RideTheVibe/engineering-docs/README.md

# engineering-docs

Engineering Docs for Vibe - The One Wheel Self-Balancing E-Bike
