RideTheVibe/engineering-docs/content/docs/AllDownloadables.mdx

---
title: All Downloadables
description: All downloadable files in one easy place.
---

import {DownloadCard} from "../../src/Components/DownloadCard/DownloadFile";

## Electrical

<DownloadCard fileName={"DMU11-BreakoutBoard-gerber.zip"} fileLocation={"/files/dmu11-mating-connector.zip"} />

## Fabrication

### Metal
<DownloadCard fileName={"TODO-Vibe-Fusion360-Files.zip"} fileLocation={"/files/dmu11-mating-connector.zip"} />
<DownloadCard fileName={"Vibe-ControlBox-SheetMetalFlatPattern.dxf"} fileLocation={"/files/ControlBoxSheetMetalFlatPattern.dxf"} />
<DownloadCard fileName={"Vibe-Frame-SeatStayBendDiagram.pdf"} fileLocation={"/files/SeatStayBendDiagram.pdf"} />
<DownloadCard fileName={"Vibe-Frame-SeatCageDiagram.pdf"} fileLocation={"/files/SeatCageDiagram.pdf"} />
<DownloadCard fileName={"Vibe-Frame-HandleBarStemDiagram.pdf"} fileLocation={"/files/HandleBarStemDiagram.pdf"} />
<DownloadCard fileName={"Vibe-Frame-Dropout.step"} fileLocation={"/files/Dropout.step"} />

### 3D Printing
<DownloadCard fileName={"Vibe-DMU11-IMU-Enclosure.stl"} fileLocation={"/files/IMUEnclosure.stl"} />
<DownloadCard fileName={"Vibe-Dashboard-Enclosure-Top.stl"} fileLocation={"/files/DashboardEnclosureTop.stl"} />
<DownloadCard fileName={"Vibe-Dashboard-Enclosure-Lid.stl"} fileLocation={"/files/DashboardEnclosureLid.stl"} />

## Software

### BMS config file
<DownloadCard fileName={"Vibe-BMSConfig.xml"} fileLocation={"/files/vibe-bms-config.xml"}/>

### VESC Firmware bin
<DownloadCard fileName={"Vibe-VESC-FW6.05"} fileLocation={"/files/vibe-vescfwv6.05-100_250_mkiii.bin"}/>
