RideTheVibe/engineering-docs/public/files/HandleBarStemDiagram.pdf

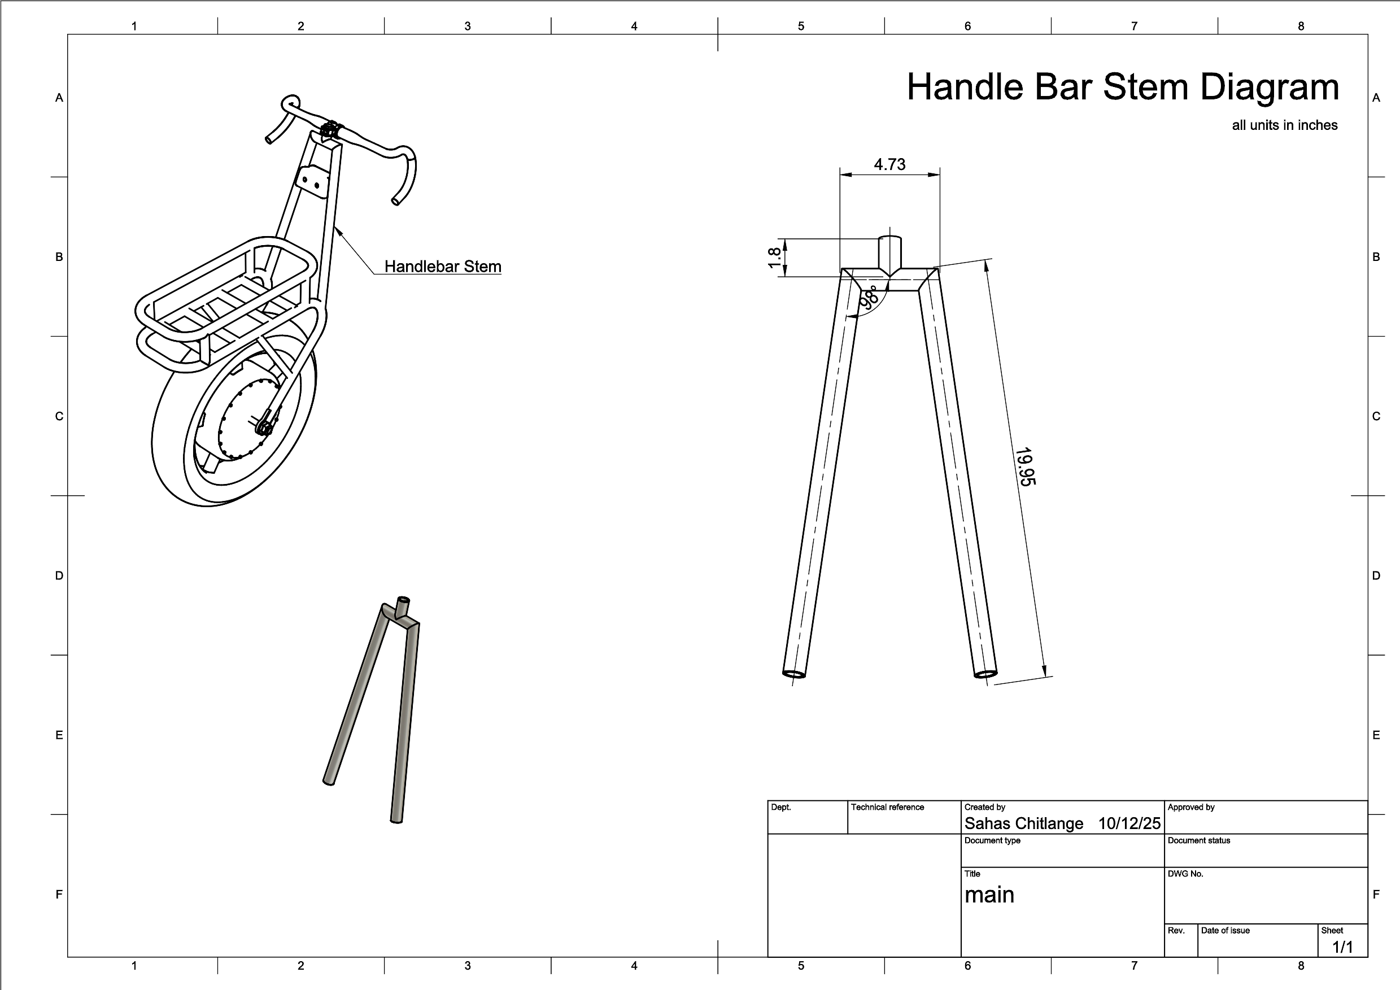
[picture p1: page 1]
