RideTheVibe/engineering-docs/public/files/SeatCageDiagram.pdf

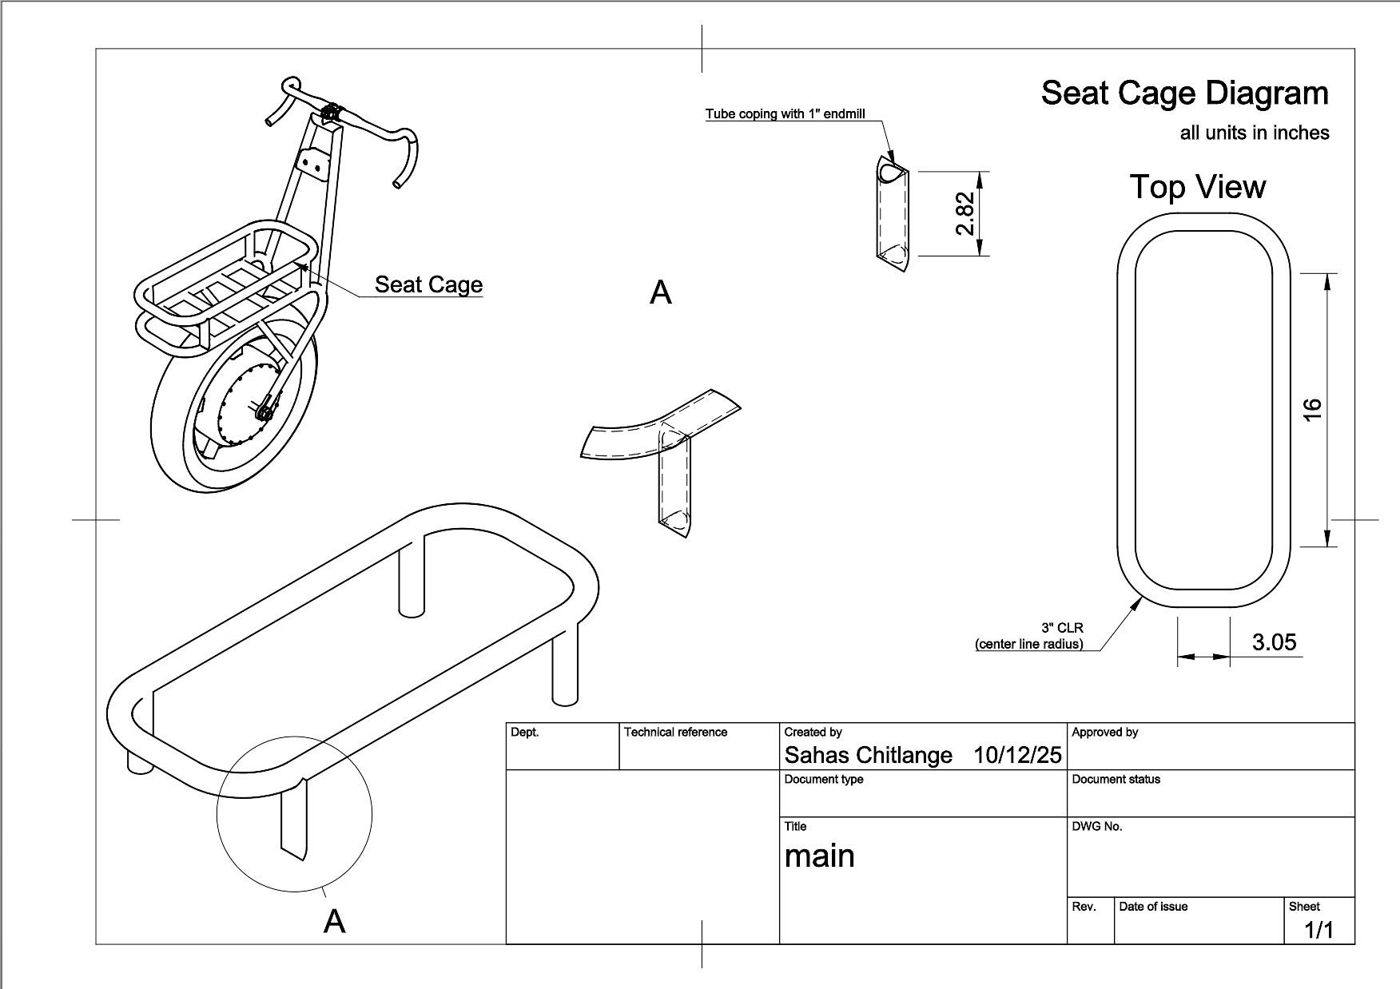
[picture p2: page 1]
