RideTheVibe/engineering-docs/public/files/SeatStayBendDiagram.pdf

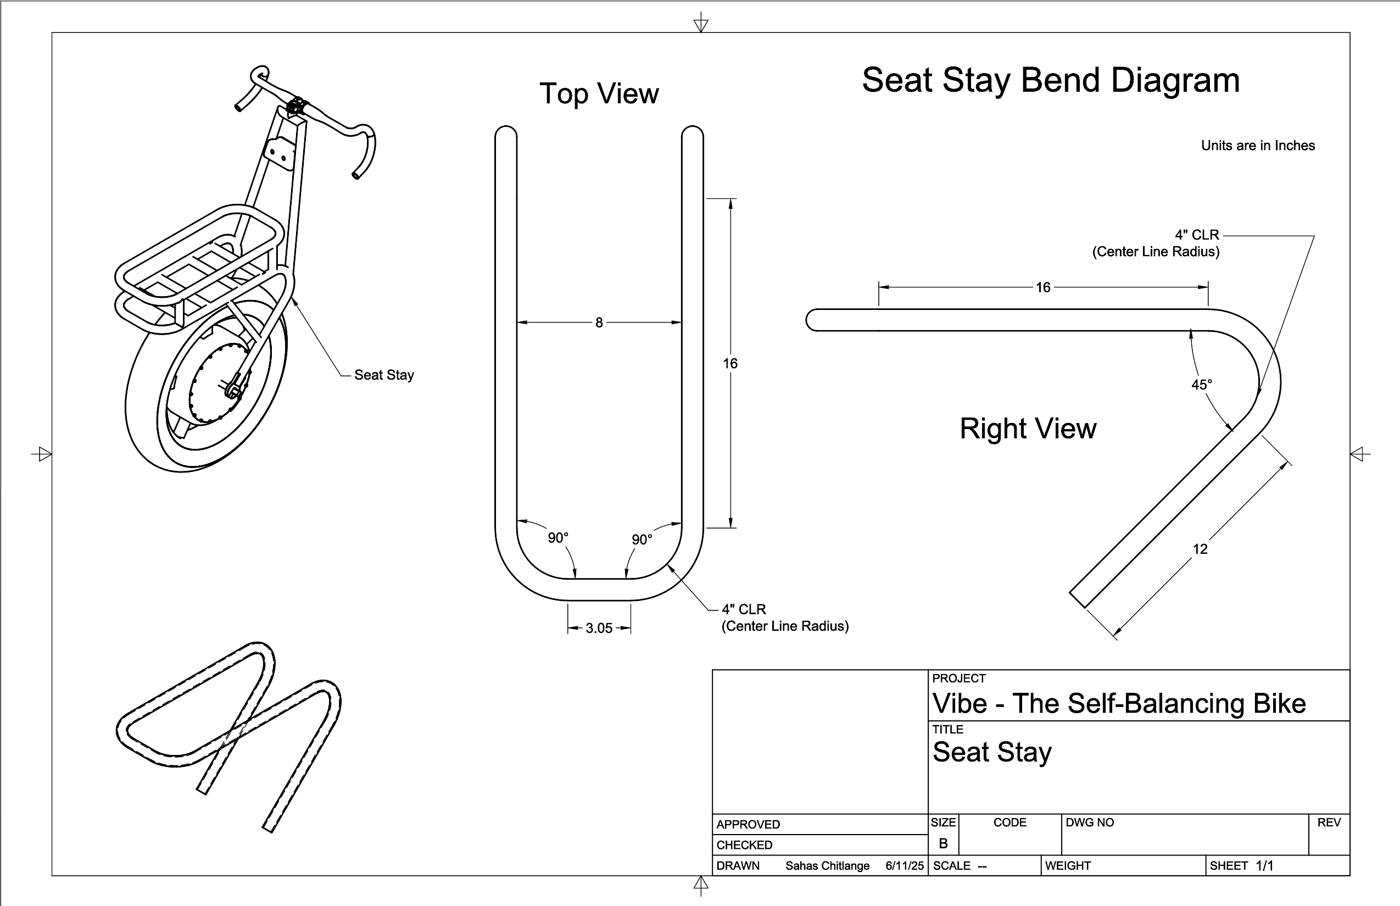
[picture p3: page 1]
