RideTheVibe/engineering-docs/content/docs/(Electrical)/images/ControlBoxSystemDiagramDark.png

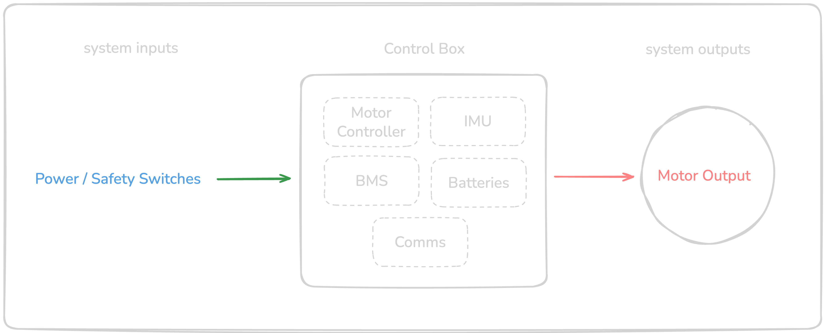
content/docs/(Electrical)/images/ControlBoxSystemDiagramDark.png
