RideTheVibe/engineering-docs/content/docs/(Electrical)/images/ControlBoxSystemDiagramLight.png

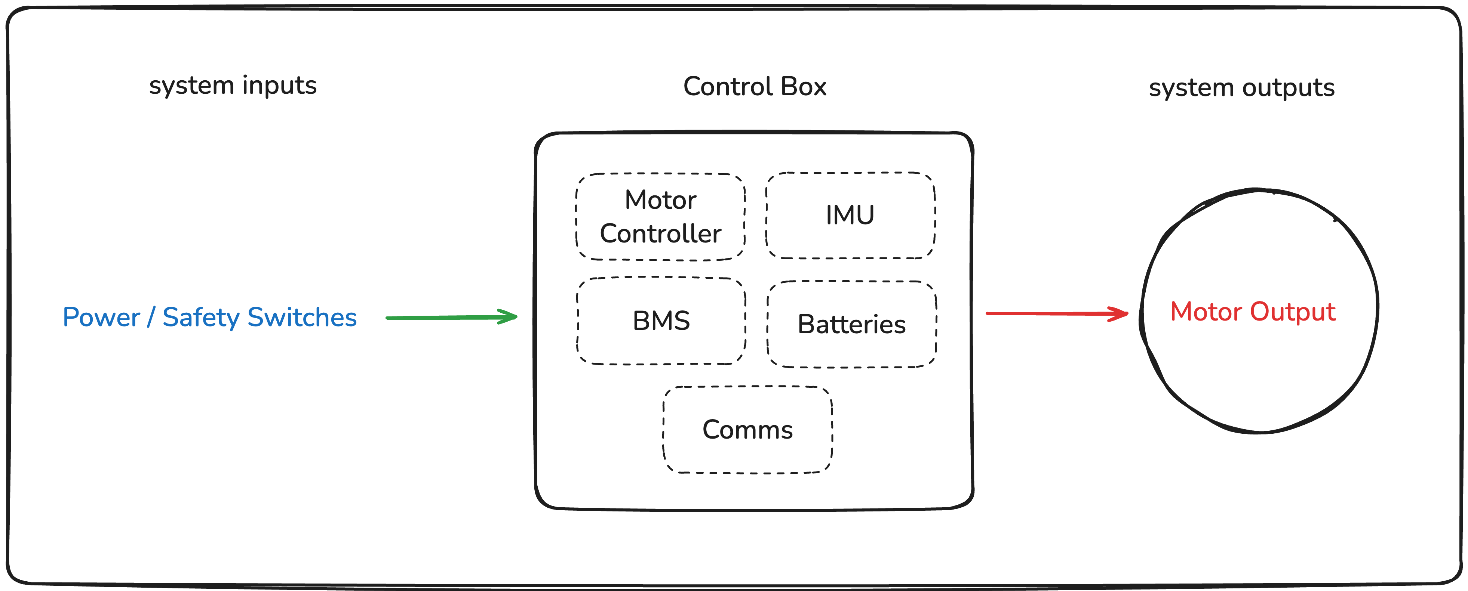
content/docs/(Electrical)/images/ControlBoxSystemDiagramLight.png
