RideTheVibe/engineering-docs/content/docs/(Electrical)/images/ElectricalDiagramDark.png

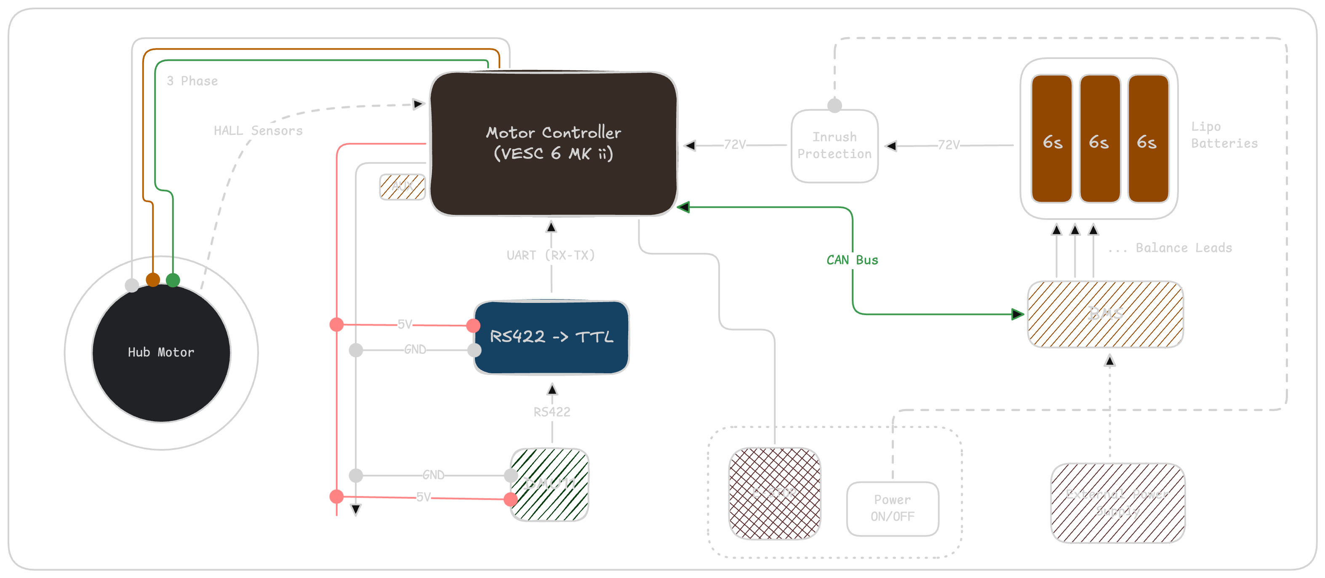
content/docs/(Electrical)/images/ElectricalDiagramDark.png
