RideTheVibe/engineering-docs/content/docs/(Electrical)/images/ElectricalDiagramLight.png

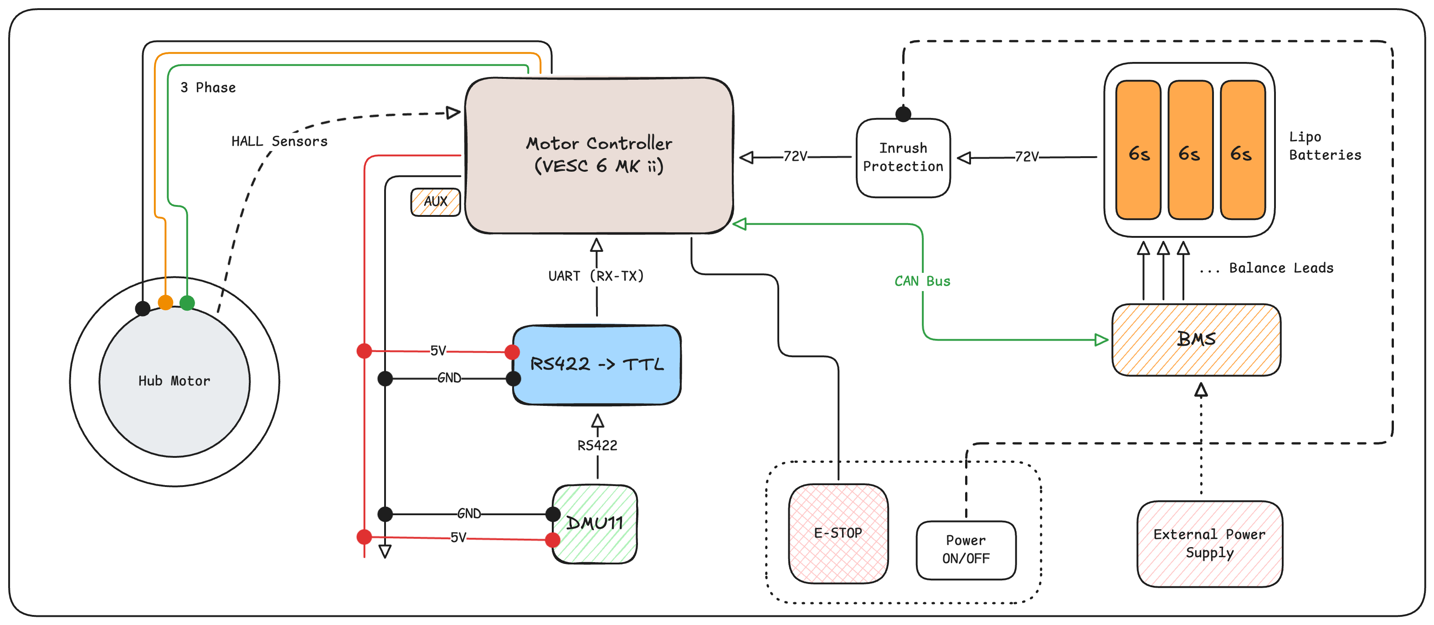
content/docs/(Electrical)/images/ElectricalDiagramLight.png
