RideTheVibe/engineering-docs/content/docs/(Electrical)/images/sm_black_top.png

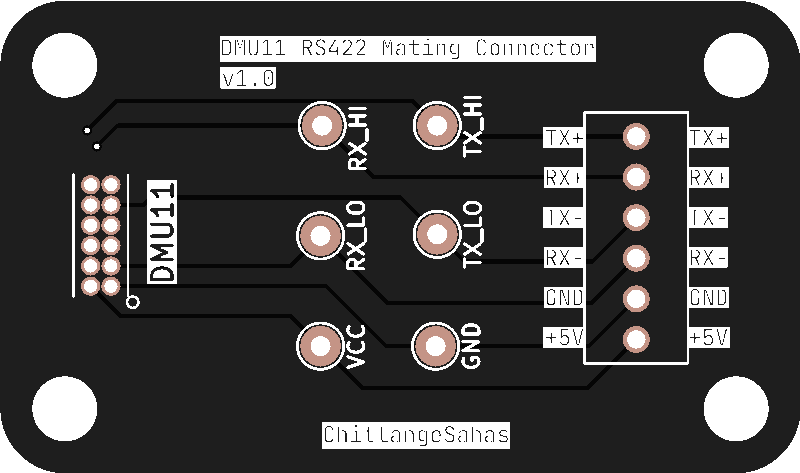
content/docs/(Electrical)/images/sm_black_top.png
