RideTheVibe/engineering-docs/content/docs/(Fabrication)/images/Overview.png

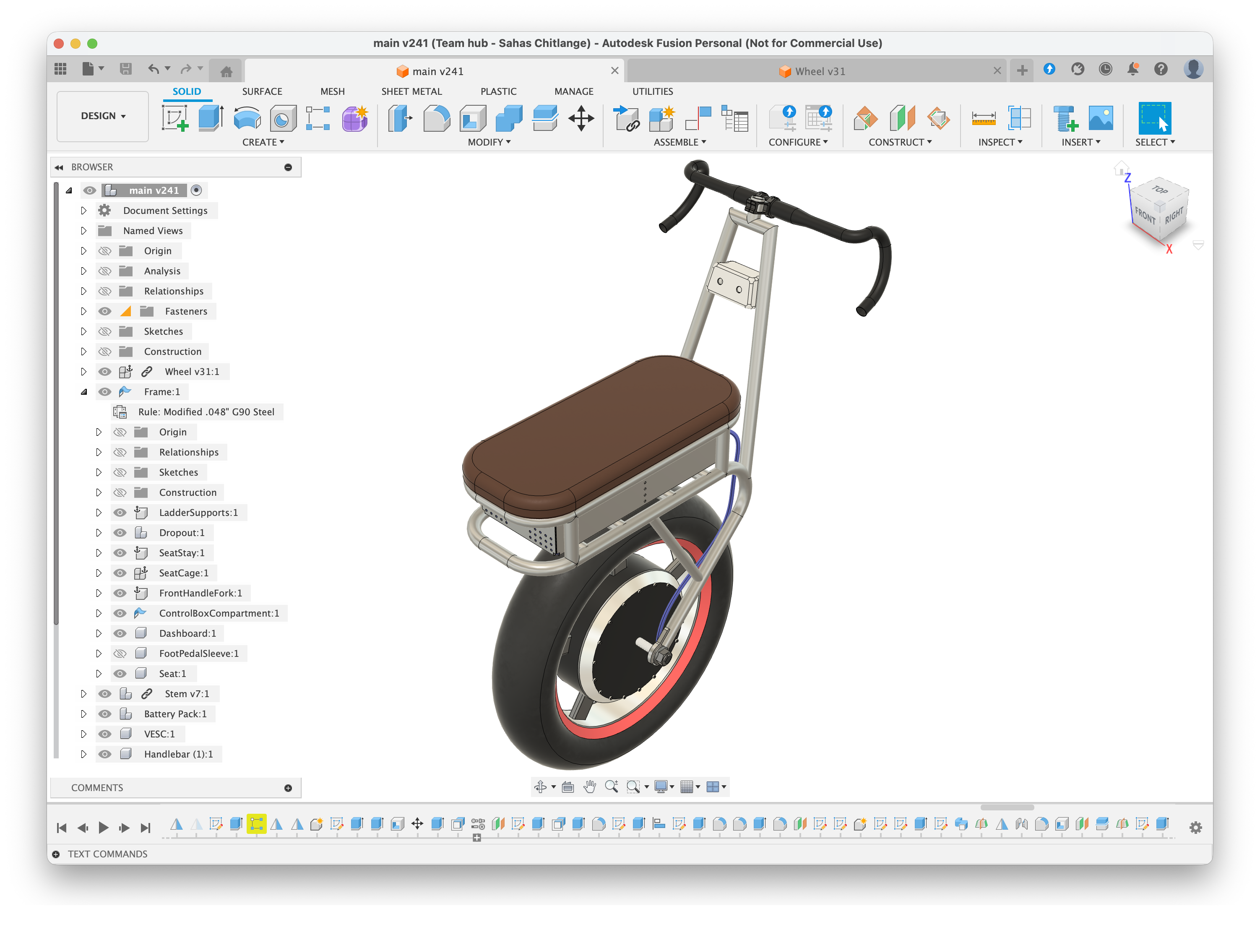
content/docs/(Fabrication)/images/Overview.png
