RideTheVibe/engineering-docs/content/docs/images/HowDoesVibeWork.png

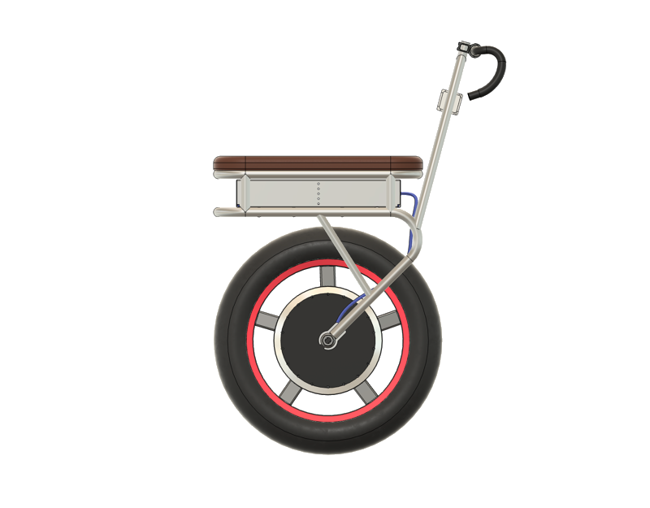
content/docs/images/HowDoesVibeWork.png
