RideTheVibe/engineering-docs/content/docs/images/HowDoesVibeWorkAnnotatedDark.png

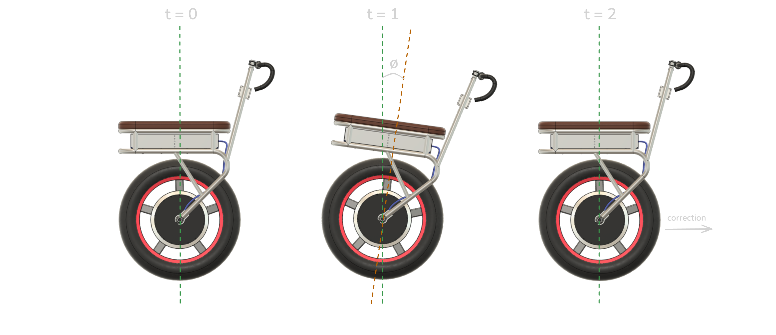
content/docs/images/HowDoesVibeWorkAnnotatedDark.png
