RideTheVibe/engineering-docs/public/files/DashboardEnclosureTop.stl

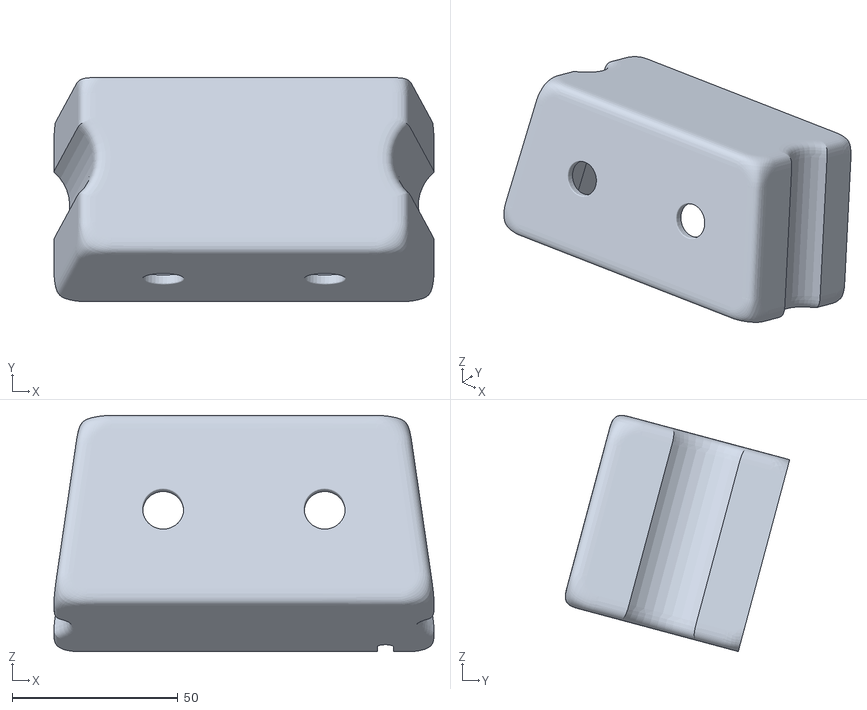
[picture p12: CAD file, 2025-10-24]
public/files/DashboardEnclosureTop.stl
114.8 x 67.8 x 71.3
