RideTheVibe/engineering-docs/public/files/DashboardEnclosureLid.stl

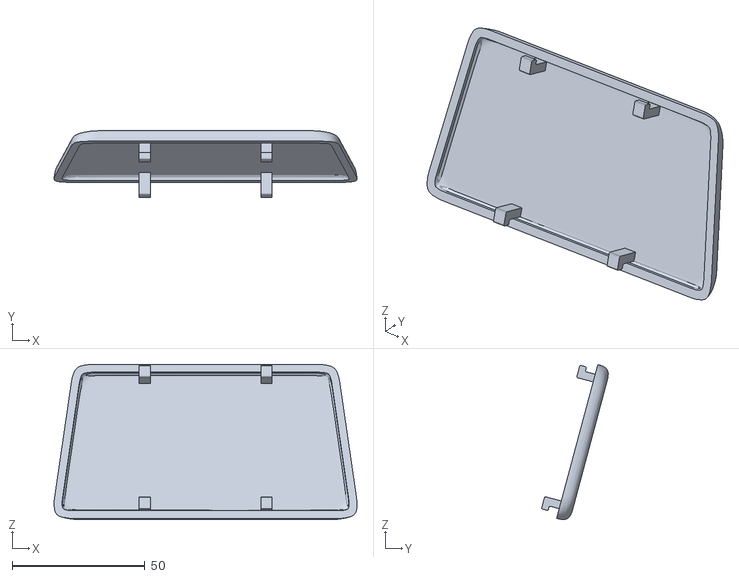
[picture p13: CAD file, 2025-10-24]
public/files/DashboardEnclosureLid.stl
114.1 x 25.1 x 58.4
