RideTheVibe/engineering-docs/public/files/IMUEnclosure.stl

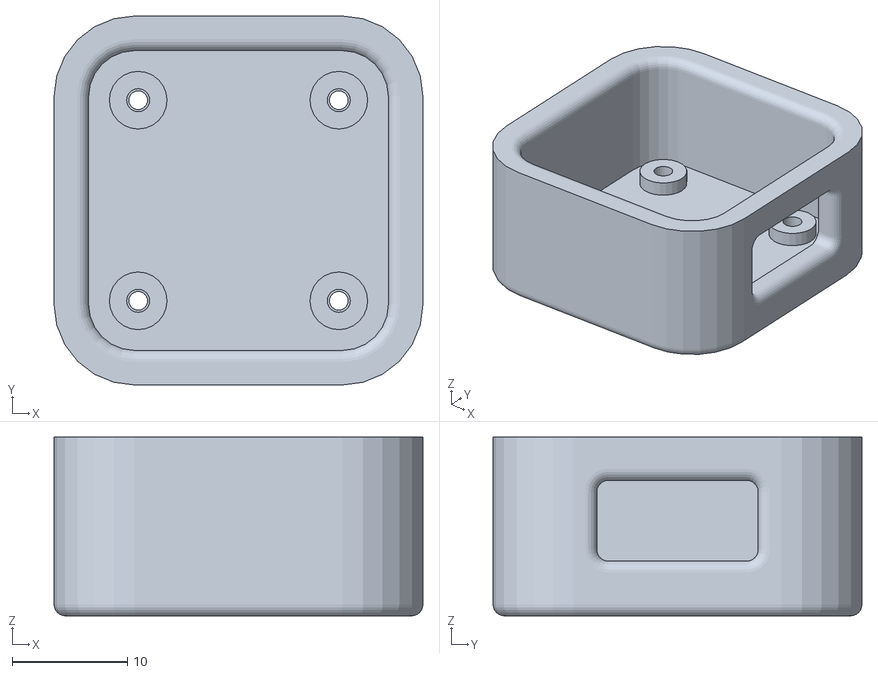
[picture p14: CAD file, 2025-10-12]
public/files/IMUEnclosure.stl
32.0 x 32.0 x 15.5
