RideTheVibe/engineering-docs/public/files/Dropout.step

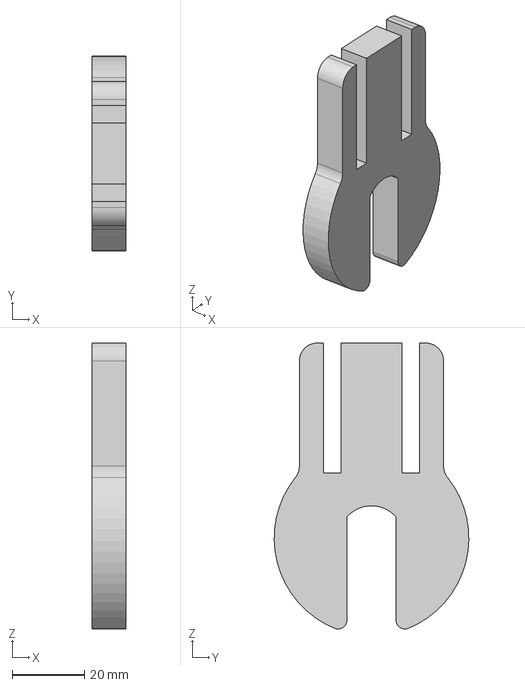
[picture p15: CAD file, 2025-10-12]
public/files/Dropout.step
9.52 x 54.0 x 79.3 mm
