RideTheVibe/engineering-docs/public/files/ControlBoxSheetMetalFlatPattern.dxf

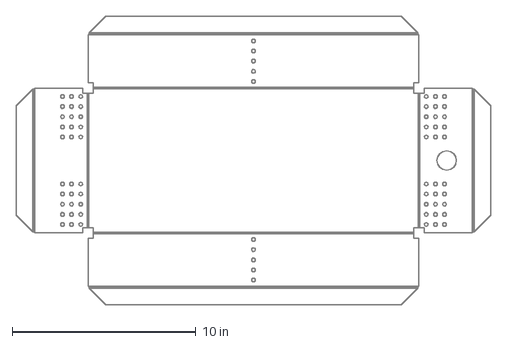
[picture p16: CAD file, 2025-10-12]
public/files/ControlBoxSheetMetalFlatPattern.dxf
25.8 x 15.7 in
