RideTheVibe/engineering-docs/content/docs/(Fabrication)/DashboardEnclosure.mdx

---
title: Dashboard Enclosure
---

import ImageProvider from "../../../src/Components/ImageProvider";
import dashboardEnclosure from "./images/DashboardEnclosure.png";
import dashboardEnclosureAssembly from "./images/DashboardEnclosureAssembly.png";
import {DownloadCard} from "../../../src/Components/DownloadCard/DownloadFile";

The dashboard enclosure is 3D printed and houses the Power and Emergency Stop button. It is mounted to the handle bar stems with permanent
silicon adhesive tape.

<ImageProvider lightImage={dashboardEnclosure} darkImage={dashboardEnclosure}/>

## Assembly

The two parts are snap fit together.

<ImageProvider lightImage={dashboardEnclosureAssembly} darkImage={dashboardEnclosureAssembly}/>

## 3D Print Files

Please use the following file to print the dashboard enclosure.
<DownloadCard fileName={"Vibe-Dashboard-Enclosure-Top.stl"} fileLocation={"/files/DashboardEnclosureTop.stl"} />
<DownloadCard fileName={"Vibe-Dashboard-Enclosure-Lid.stl"} fileLocation={"/files/DashboardEnclosureLid.stl"} />
