RideTheVibe/engineering-docs/content/docs/(Fabrication)/IMUEnclosure.mdx

---
title: IMU Enclosure
---

The DMU11 IMU is housed in a 3D-printed enclosure mounted inside the control box using permanent silicone mounting tape. This provides isolation from vibrations and electrical contact with other components in the control box.

import {DownloadCard} from "../../../src/Components/DownloadCard/DownloadFile";

import imuEnclosure from "./images/IMUEnclosure.png";

import ImageProvider from "../../../src/Components/ImageProvider";

<ImageProvider lightImage={imuEnclosure} darkImage={imuEnclosure}/>

## 3D print file
<DownloadCard fileName={"Vibe-DMU11-IMU-Enclosure.stl"} fileLocation={"/files/IMUEnclosure.stl"} />
