RideTheVibe/engineering-docs/content/docs/(Fabrication)/ControlBoxFabrication.mdx

---
title: Control Box Fabrication
---

The control box is fabricated using precision-cut sheet metal, given the structural rigidity and manufacturing repeatability this method offers.
The design is optimized for CNC laser cutting and CNC press brake bending. All bend reliefs, hole diameters, and tab geometries are modeled with common sheet-metal fabrication service's design tolerances.

import ImageProvider from "../../../src/Components/ImageProvider";
import controlBoxFlatPatternLight from "./images/ControlBoxFlatPatternLight.png";
import controlBox from "./images/ControlBoxRender.png";

<ImageProvider lightImage={controlBox} darkImage={controlBox}/>

---

## Flat Pattern

To have the control box manufactured, please upload the flat pattern to the sheet metal fabrication service of your choice, the DXF file contains the cut lines as well as the bend lines needed.

<ImageProvider lightImage={controlBoxFlatPatternLight} darkImage={controlBoxFlatPatternLight}/>

import {DownloadCard} from "../../../src/Components/DownloadCard/DownloadFile";

<DownloadCard fileName={"Vibe-ControlBox-SheetMetalFlatPattern.dxf"} fileLocation={"/files/ControlBoxSheetMetalFlatPattern.dxf"} />

---
