RideTheVibe/engineering-docs/content/docs/(Fabrication)/FrameFabrication.mdx

---
title: Frame Fabrication
---

import ImageProvider from "../../../src/Components/ImageProvider";
import frameRenderAnnotated from "./images/FrameWithHandleBarAnnotated.png";

The frame is made out of 14 Gauge mild steel tubing, using Tube Bending, Tube Coping and MIG welding manufacturing processes. Here is an annotated visual for better clarity of the names:
<ImageProvider lightImage={frameRenderAnnotated} darkImage={frameRenderAnnotated} height={800}/>

The frame is composed of the following subcomponents:

- Seat Stay
- Seat Cage
- Ladder Supports
- Handle Bar Stem
- Dropouts

The CAD software used to design the frame is Fusion360 and the drawing files will be shared through AutoDesk 360 links below. Backup PDFs are also available in the Metal section of the [All Downloadables](/docs/AllDownloadables#metal) page.
## Seat Stay

<iframe
    src="https://gmail5210078.autodesk360.com/g/shares/SH90d2dQT28d5b602811937b456b44379443"
    width="100%"
    height="750px"
    style={{ border: "1px solid #ddd", borderRadius: "8px" }}
/>

## Seat Cage

<iframe
    src="https://gmail5210078.autodesk360.com/g/shares/SH90d2dQT28d5b60281169521529cd970a70"
    width="100%"
    height="750px"
    style={{ border: "1px solid #ddd", borderRadius: "8px" }}
/>

## Handle Bar Stems

<iframe
    src="https://gmail5210078.autodesk360.com/g/shares/SH90d2dQT28d5b60281159834110cdcef902"
    width="100%"
    height="750px"
    style={{ border: "1px solid #ddd", borderRadius: "8px" }}
/>

## Dropout

<iframe
    src="https://gmail5210078.autodesk360.com/g/shares/SH90d2dQT28d5b602811af1ccccfc42e2b9e"
    width="100%"
    height="750px"
    style={{ border: "1px solid #ddd", borderRadius: "8px" }}
/>
