RideTheVibe/engineering-docs/content/docs/(Electrical)/images/BMSWiringDark.png

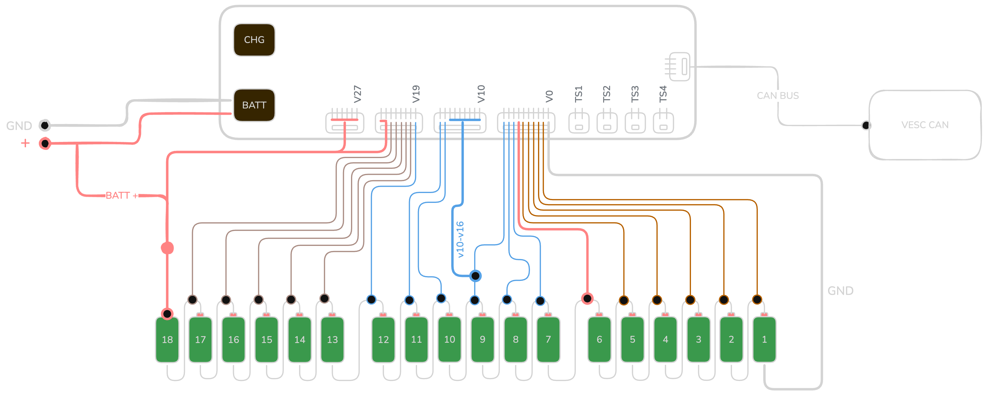
content/docs/(Electrical)/images/BMSWiringDark.png
