RideTheVibe/engineering-docs/content/docs/(Electrical)/images/BMSWiringLight.png

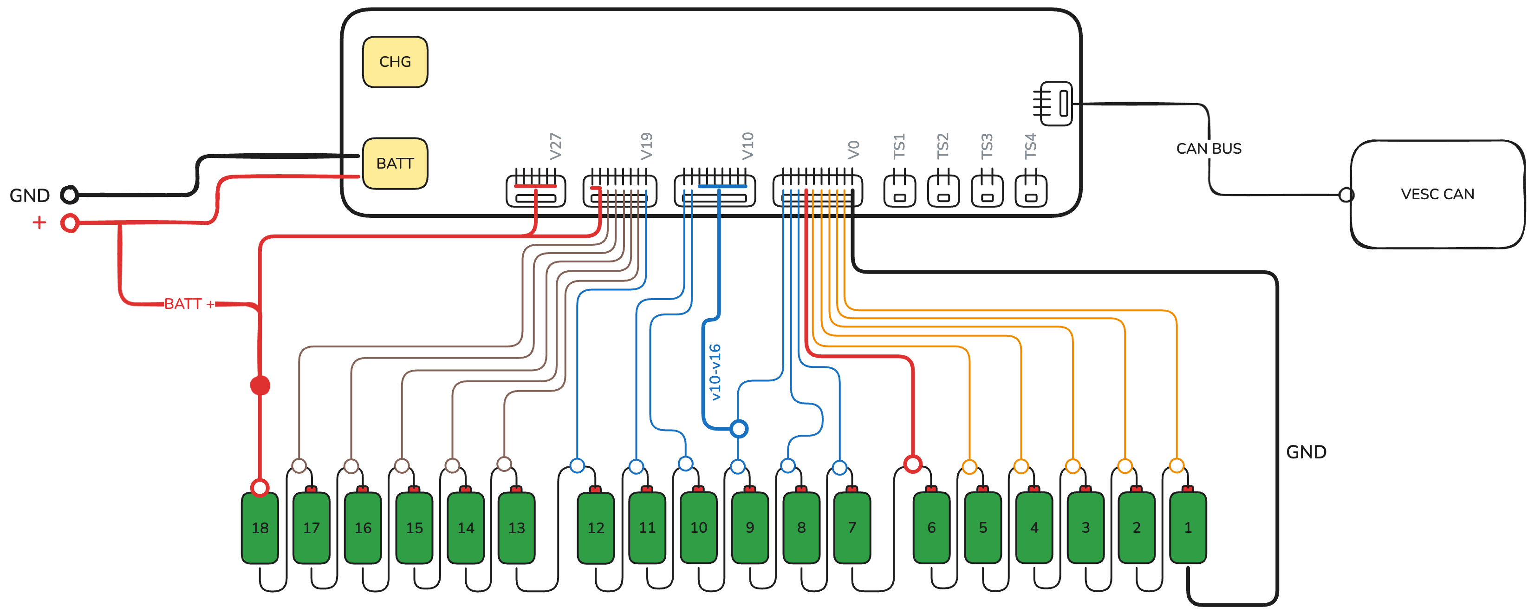
content/docs/(Electrical)/images/BMSWiringLight.png
