RideTheVibe/engineering-docs/content/docs/(Electrical)/images/DMUWiringDiagramDark.png

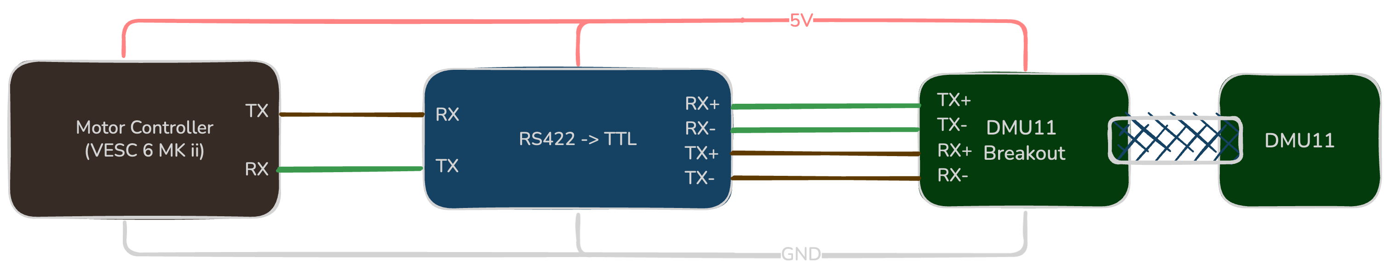
content/docs/(Electrical)/images/DMUWiringDiagramDark.png
