RideTheVibe/engineering-docs/content/docs/(Fabrication)/images/ControlBoxFlatPatternLight.png

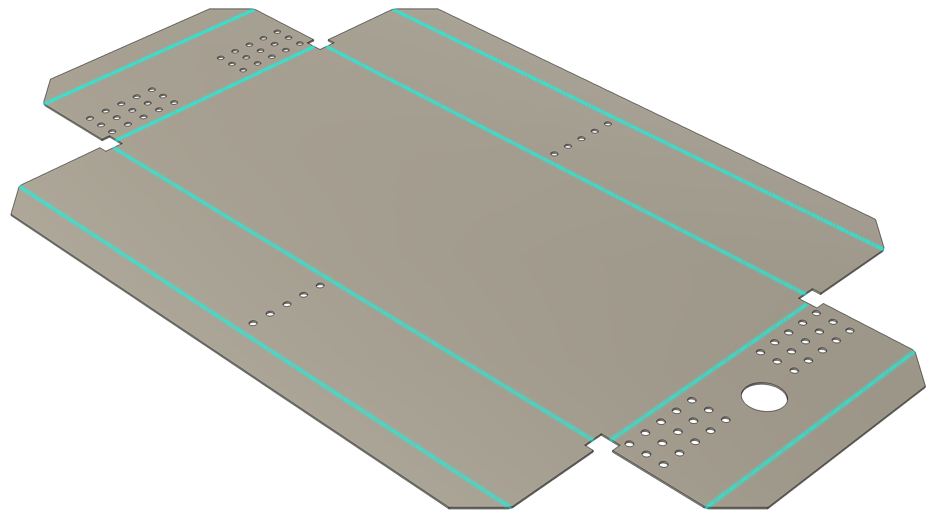
content/docs/(Fabrication)/images/ControlBoxFlatPatternLight.png
