RideTheVibe/engineering-docs/content/docs/(Fabrication)/images/ControlBoxRender.png

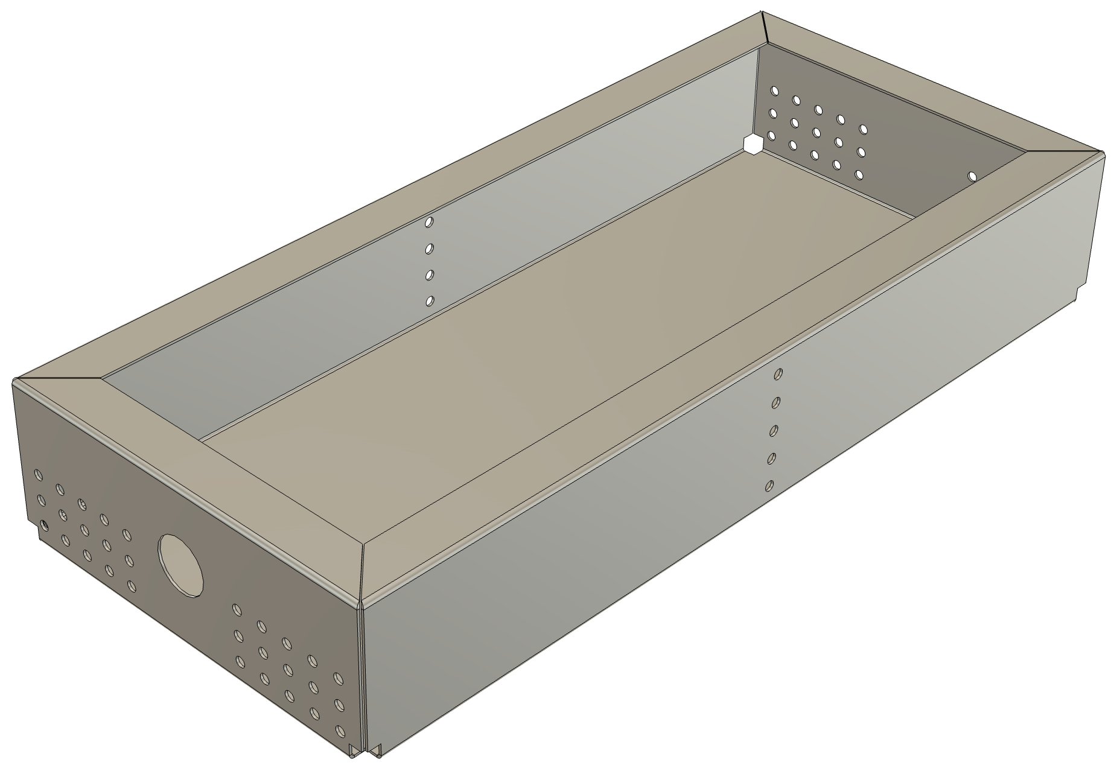
content/docs/(Fabrication)/images/ControlBoxRender.png
