RideTheVibe/engineering-docs/content/docs/(Fabrication)/images/DashboardEnclosure.png

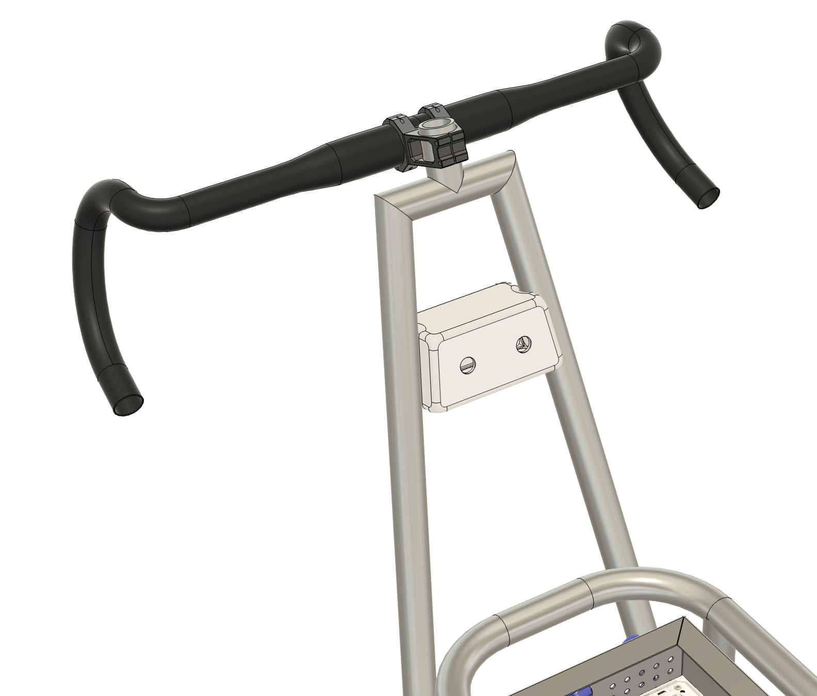
content/docs/(Fabrication)/images/DashboardEnclosure.png
