RideTheVibe/engineering-docs/content/docs/(Fabrication)/images/DashboardEnclosureAssembly.png

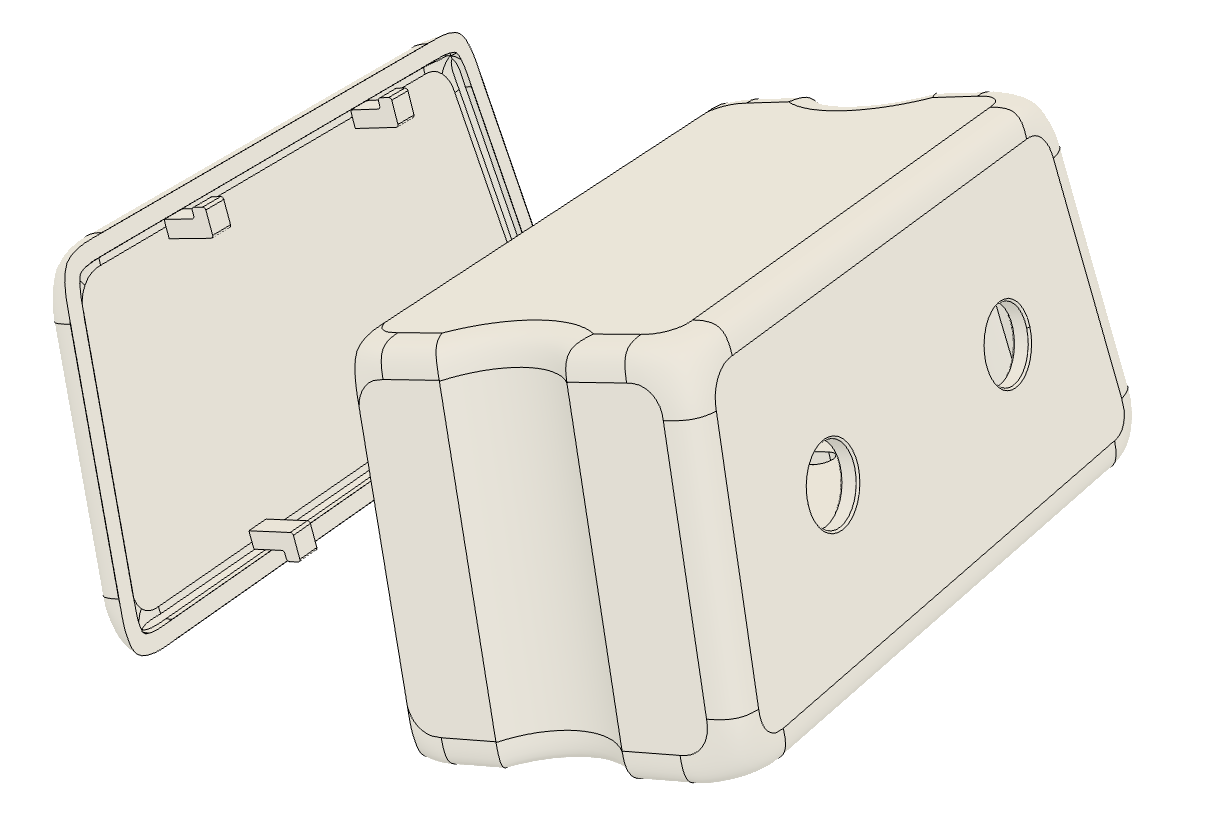
content/docs/(Fabrication)/images/DashboardEnclosureAssembly.png
