RideTheVibe/engineering-docs/content/docs/(Fabrication)/images/FrameRenderAnnotated.png

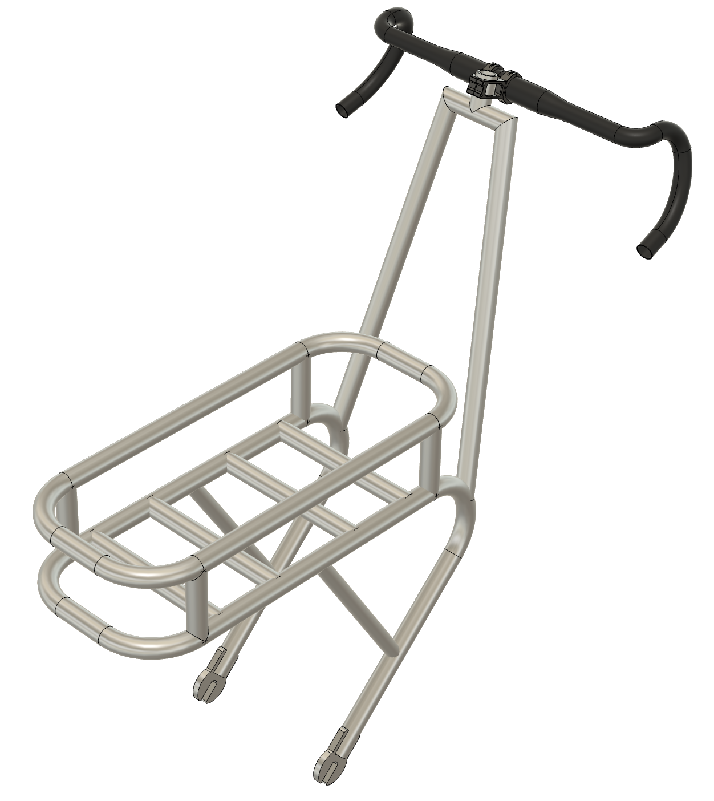
content/docs/(Fabrication)/images/FrameRenderAnnotated.png
