RideTheVibe/engineering-docs/content/docs/(Fabrication)/images/FrameWithHandleBarAnnotated.png

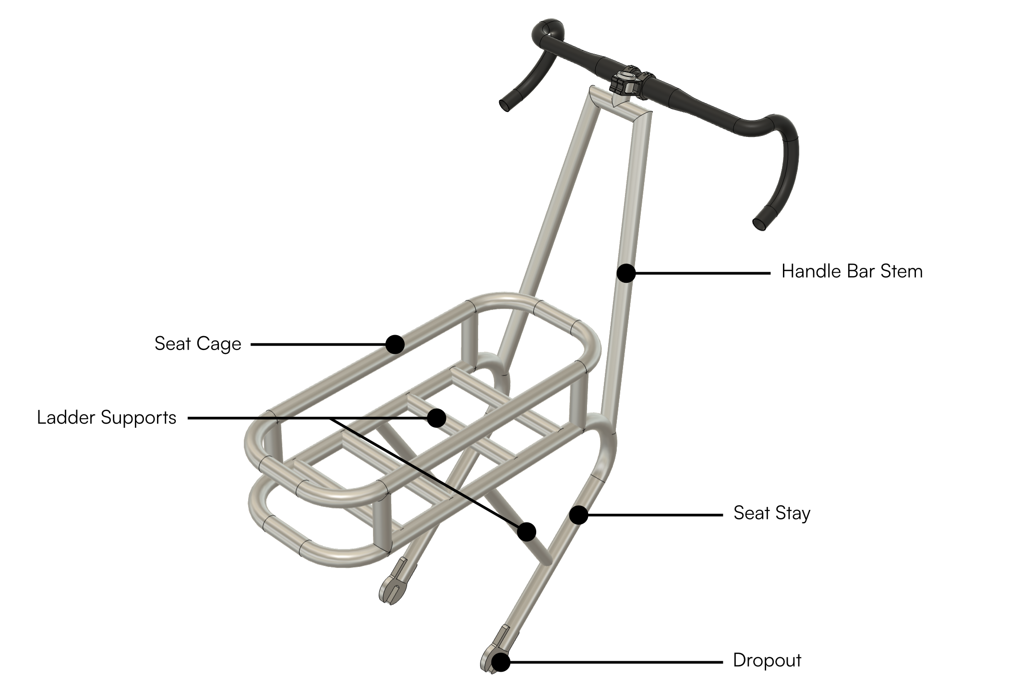
content/docs/(Fabrication)/images/FrameWithHandleBarAnnotated.png
