RideTheVibe/engineering-docs/content/docs/(Fabrication)/images/IMUEnclosure.png

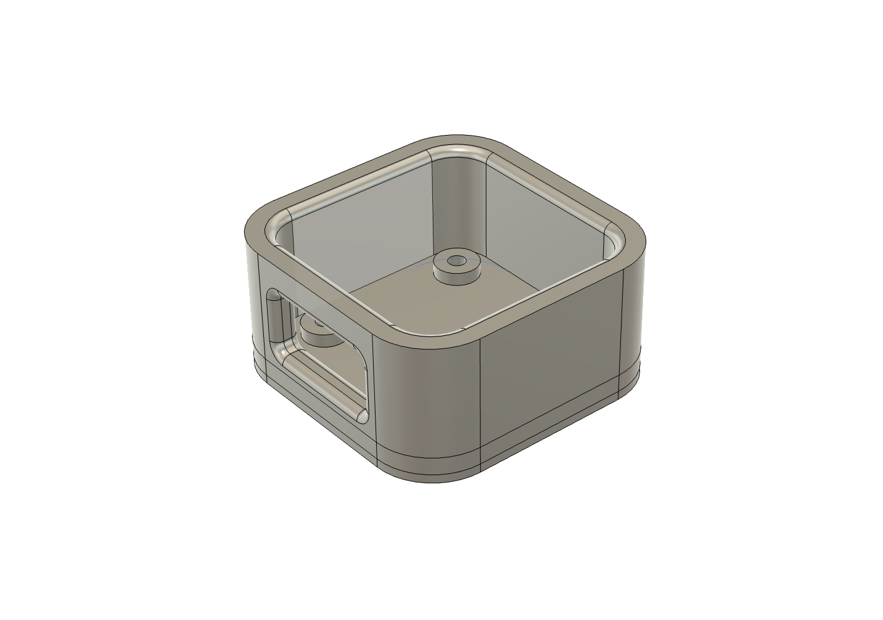
content/docs/(Fabrication)/images/IMUEnclosure.png
