RideTheVibe/engineering-docs/content/docs/(Fabrication)/images/SeatStayBendDiagram.png

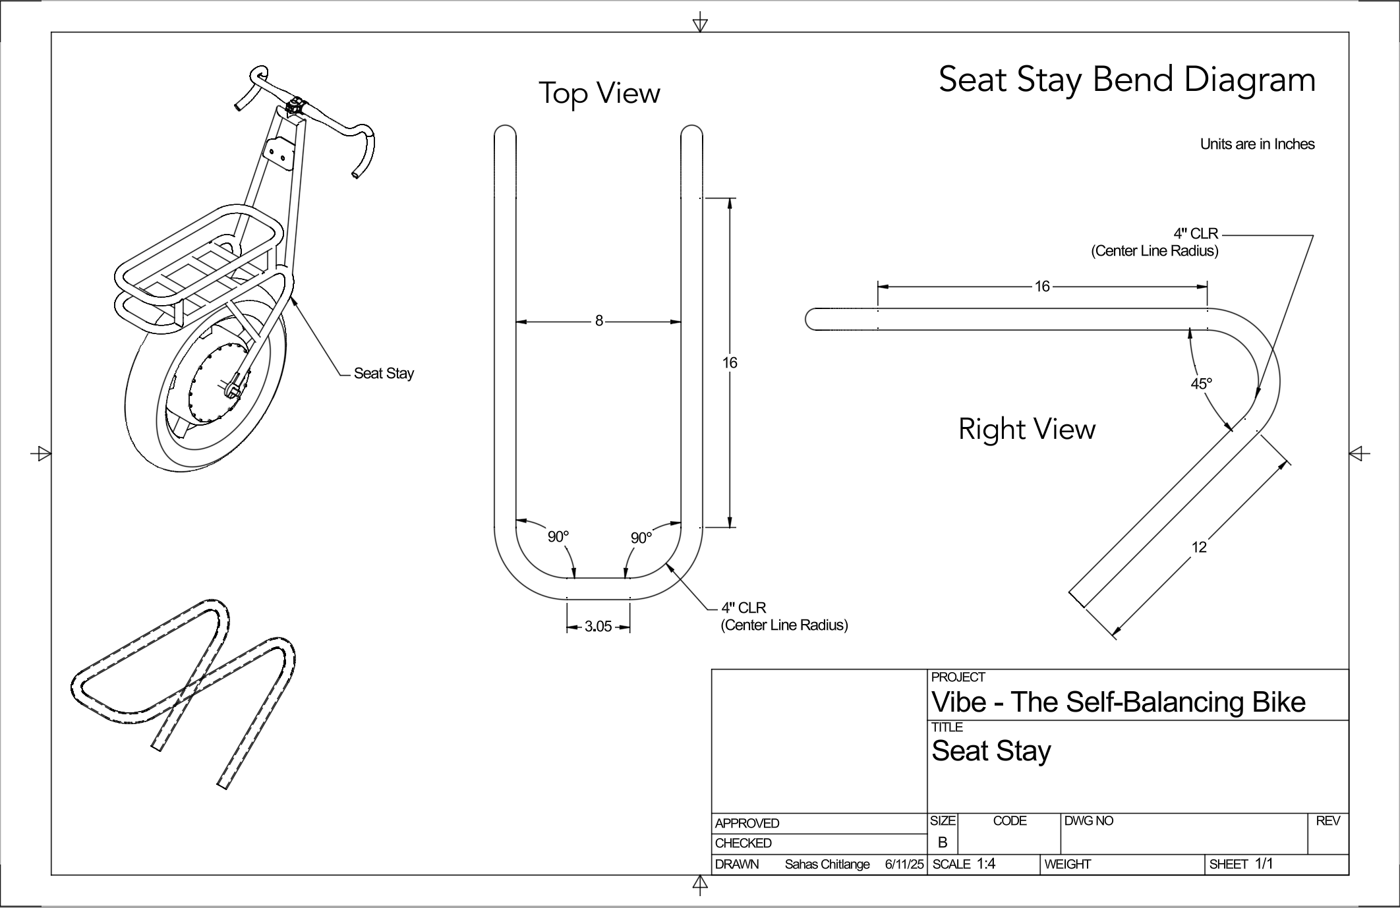
content/docs/(Fabrication)/images/SeatStayBendDiagram.png
