RideTheVibe/engineering-docs/(commit log)

2025-10-08 Control wiring is here
2025-10-11 BMS wiring diagram is in
2025-10-11 IMU section is good to go
2025-10-12 added control box fabrication files and docs
    [ControlBoxSheetMetalFlatPattern.dxf]
2025-10-12 frame documentation is in
    [Dropout.step, IMUEnclosure.stl]
2025-10-20 vesc file in all downloadables
2025-10-22 imu enclosure done
2025-10-24 dashboard enclosure done
    [DashboardEnclosureLid.stl, DashboardEnclosureTop.stl]
